jibrailjasonlee/Rover-1/docs/rover_overview.html

# Rover-1

A two-wheel rover you drive from a phone browser. Each wheel has an encoder and its own speed loop, so it holds a speed and goes straight instead of drifting. A sonar on the front is meant to stop it before it hits a wall. Everything printed fits on a Bambu A1 Mini.

Plate150 × 110 × 4 mm

Support2 wheels + caster

No-load top speed≈ 0.33 m/s

Plate height38 mm off floor

BrainESP32, 3.3 V

StatusCAD v2, not driving yet

Sheet 1 · The whole rover

## Click any part to see where it lives and why it is there

Plan, side and a full 3D model, all to scale from the CAD. In 3D, drag to orbit, scroll to zoom and use Explode to pull the assembly apart. Solid parts exist in the model or on your desk. Dashed boards are proposed positions, because the ESP32 and driver mounts are the one thing not designed yet.

Plan Side 3D

From above X-ray Under the plate

Proposed boards

IsoTopFrontSideUnderside

Explode Spin Drag to orbit · scroll to zoom · right-drag to pan · click a part

Printed PLA Wheels Motors, caster Boards Power Sensor

Sheet 2 · Why the motors hang under the plate

## One number set the whole layout: 38 mm

The first layout put the motor brackets on top of the plate. The real caster is 34.5 mm tall, so that layout was never going to work. Flipping the brackets underneath made the numbers line up, and the wheel then needed a notch in the plate.

Wheel radius 21 mm, axle 19 mm above the plate underside (4 mm plate + 15 mm tab to axle): the wheel pokes only 2 mm below the plate, and that is all the gap a caster would get.

Everything else in the design follows from this: the 3.5 mm caster pads, the wheel notches, and the 9 mm ground clearance under the bracket block.

Sheet 3 · How it moves

## Two wheels, two speeds, one turn

A differential-drive rover has no steering. It turns because one wheel goes faster than the other. The buttons use the same five commands as the firmware web page and the same speed constants, so the numbers below are what the code asks for.

Forward Spin left Spin right Back Stop

Playback speed ×6

The loop runs every 50 ms on each wheel. The phone only changes the target. It never touches the motors directly, so a slow web request cannot stall the control.

Sheet 4 · Power and signals

## Two bucks, because the motors are 6 V and the pack is not

The pack swings from 8.4 V full to 6.0 V empty. The motors are 6 V parts, so running them from the pack would overdrive them by up to 40%. One buck holds the motors at 6.0 V. A second holds the ESP32 and sonar at 5.0 V. Everything shares one ground.

Thick orange lines are power. Thin lines are signals with their GPIO numbers. Pins are from the firmware #defines and get re-checked against the real board when the cable problem is solved.

Sheet 5 · Software and what it made

## Which tool made or checks which part

Tap a part name to jump to it in the drawing.

Sheet 6 · Bill of materials

## Everything on the rover, with where it comes from

Status is from our chat as of Oct 27, 2026. Update it as parts arrive.

Sheet 7 · What is still a guess

## Open items before this is a finished robot

Motor can depthThe bracket pocket is 15.3 mm deep. How much of the 26 mm motor is can has not been measured with calipers.

Encoder resolution700 ticks per wheel turn assumes 7 pulses per motor turn and 100:1 gearing. Turn a wheel once in bench test 3 to find out.

Board mountsThe ESP32, driver and bucks have no mounts. The dashed boards show a layout that fits, not a design.

Insert fitThe listing says 4.2 mm outer diameter and the pilot hole is 4.2 mm. Heat-set pilots are normally a little smaller than the insert. Test one on the drilled part first.

ESP32 uploadThe board will not take an upload, most likely a charge-only USB cable. Nothing in the firmware has run on hardware.

Firmware gapsPID gains are placeholders that the sim says will chatter. No failsafe if the phone drops. Obstacle stop is an empty function.

Print orientationWith pads and a tall wall, the chassis needs supports somewhere. This is decided at the slicer, before the reprint.

Caster geometryThe caster drawn here is the retailer's STEP shape. Real height and swivel sweep get checked on the part.

Rover-1 · plate 150 × 110 mm · axle 17 mm below plate · plate 38 mm above floor · numbers from docs/decisions.md D-004 to D-014
