jibrailjasonlee/Rover-1/Parts/Rover_Assembly.STEP

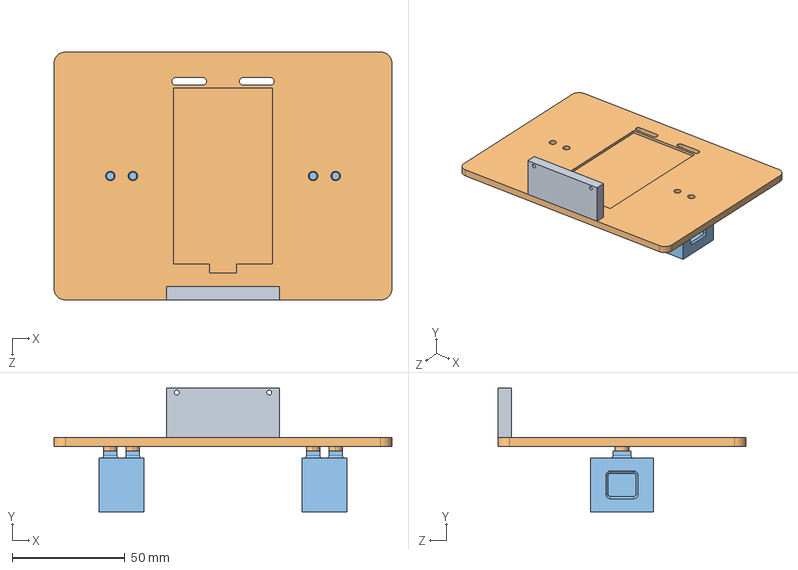
[picture p1: CAD file, 2026-10-26]
Parts/Rover_Assembly.STEP
150.0 x 55.0 x 110.0 mm
Chassis
N20_Motor_Mount_v1 x 2
