jibrailjasonlee/Rover-1/cad/Chassis.SLDPRT

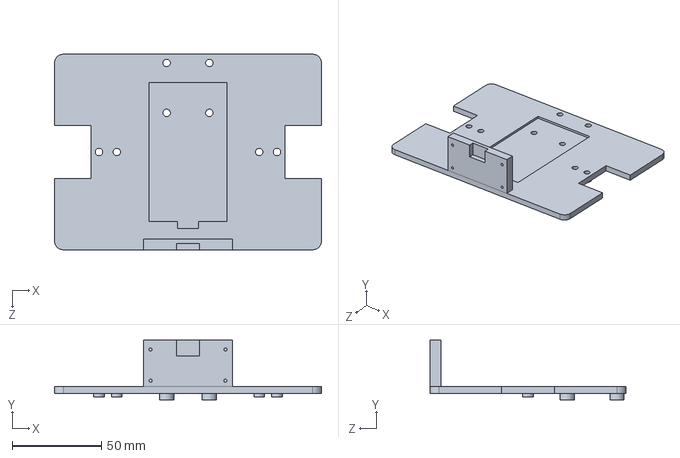
[picture p2: CAD file, 2026-10-27]
cad/Chassis.SLDPRT
150.0 x 33.5 x 110.0 mm
