jibrailjasonlee/Rover-1/Parts/N20_Motor_Mount_v1.SLDPRT

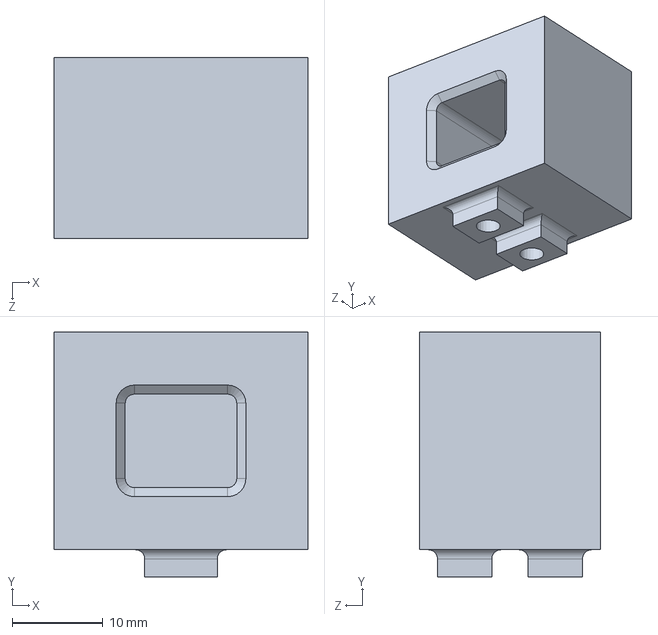
[picture p3: CAD file, 2026-10-07]
Parts/N20_Motor_Mount_v1.SLDPRT
28.0 x 27.0 x 20.0 mm
