jibrailjasonlee/Rover-1/cad/Wheel_Dummy.STEP

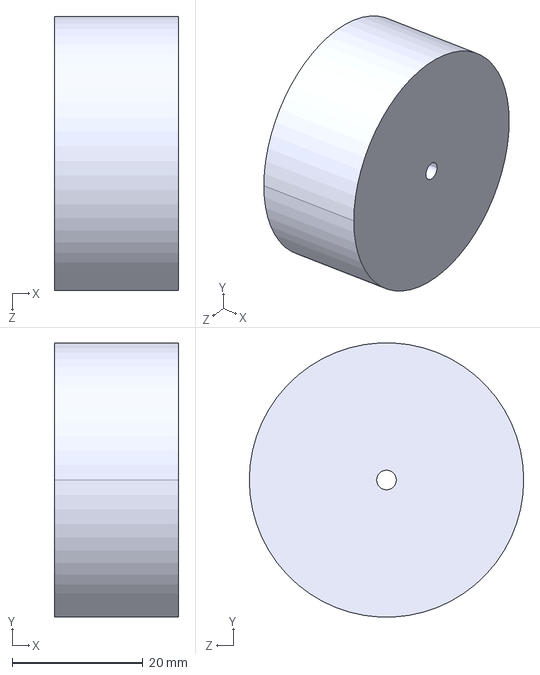
[picture p4: CAD file, 2026-10-26]
cad/Wheel_Dummy.STEP
19.0 x 41.9 x 42.0 mm
