jibrailjasonlee/Rover-1/cad/Caster Wheel.SLDASM

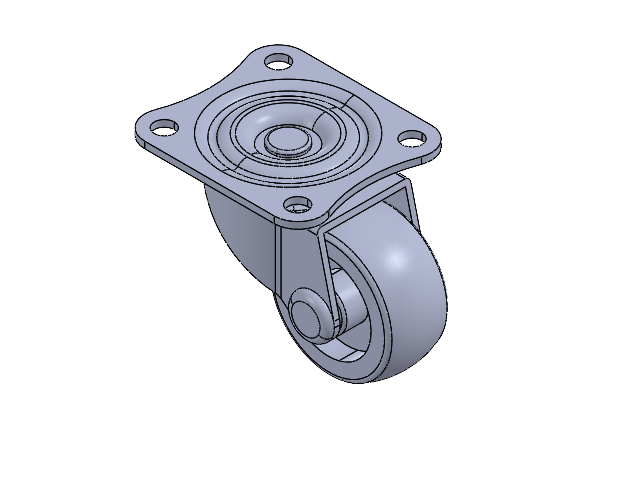
[picture p5: CAD file, 2026-10-27]
cad/Caster Wheel.SLDASM
caster base plate.STEP
caster wheel holder.STEP
pim 1.STEP
pim 2.STEP
caster wheel_1.STEP
