jibrailjasonlee/Rover-1/(list of files, cad)

Other CAD files:
Parts/Rover_Assembly.SLDASM
cad/N20_Motor_Mount_v1.3MF
cad/Rover_Assembly.SLDASM
cad/Wheel_Dummy.SLDPRT
