jibrailjasonlee/Rover-1/docs/wiring.png

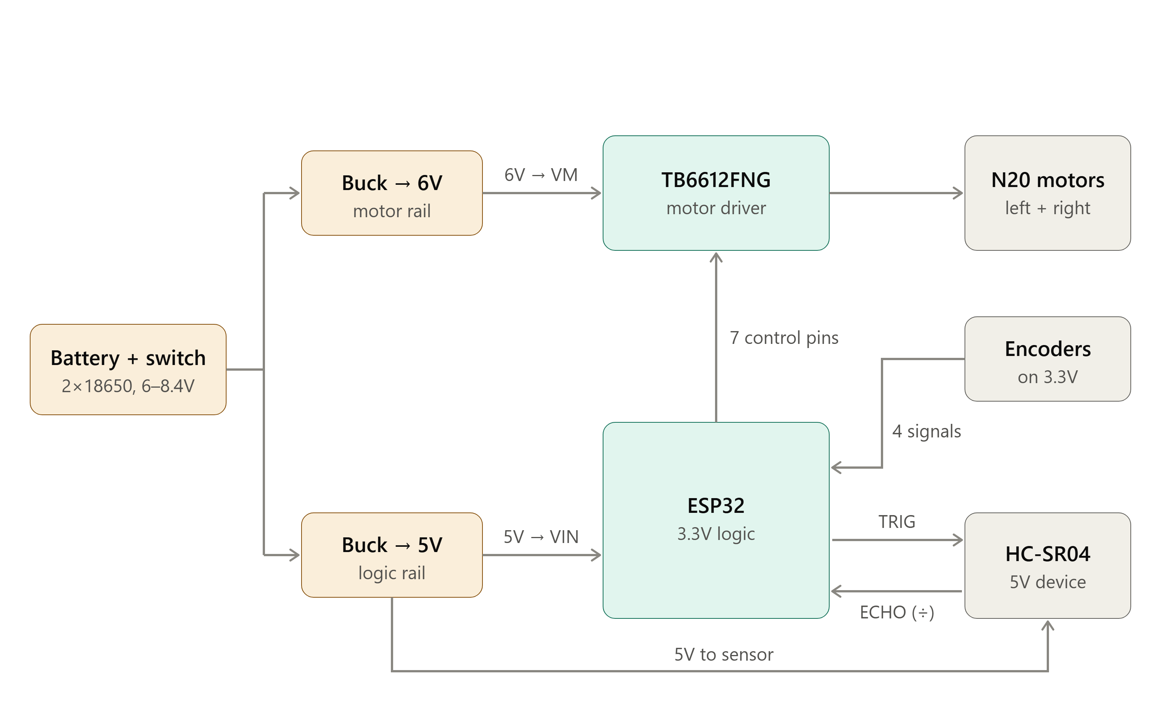
docs/wiring.png
