jibrailjasonlee/Rover-1/(commit log)

2026-10-07 Initial commit: motor mount, chassis, firmware skeleton
2026-10-07 Add encoder interrupts and non-blocking debug print
2026-10-07 Added PIDController struct and prototype for computation
2026-10-15 Added a Simulink Model to simulate the motor parameters
2026-10-18 Add rover hardware bench tests
    Add standalone ESP32 sketches for testing serial output, motor direction, encoder counts, ultrasonic distance readings, and WiFi connectivity. Also include generated Simulink simulation cache files.
2026-10-26 cut firmware comments down to the why
2026-10-26 add readme, requirements, decisions and wiring notes
2026-10-26 created assembly file
2026-10-26 fix ride height numbers, caster needs a 3.5 mm spacer
2026-10-26 add wheel wells to D-014
2026-10-26 removed wheel interference in chassis
2026-10-27 added caster wheel holes under the chassis plate
2026-10-27 imported caster wheel step from retailer
2026-10-27 added the caster wheel into the assembly and fixed orientation
2026-10-27 updated sensor wall
